HasanJamal96/bio_reactor/README.md

# bio_reactor

It is a device used to check total coliforms and E. coli in Liquids.
User place the jar in chamber and microcontroller check sample type and other information by reading its RFID tag.  
Sample Types
 - COLITAG
 - COLILERT
 - COLILERT18

after getting information device will perform specific tasks on sample and produce the results.
LEDs are used to display states.

Heating pad with PID is used to maintain certian temperature of liquid.  
After prducing result, result will be uploaded to the cloud with sample information.
