HasanJamal96/bio_reactor/Information.docx

Download and Install Arduino IDE 2.x from the following link.

https://docs.arduino.cc/software/ide-v2/tutorials/getting-started/ide-v2-downloading-and-installing

Add ESP32 board in IDE.

Go to File >> preferences.

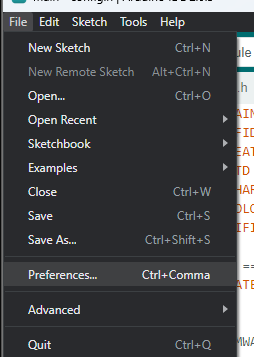
[picture p2: figure]

Add following link in Additional boards manager URLs.

https://raw.githubusercontent.com/espressif/arduino-esp32/gh-pages/package_esp32_dev_index.json

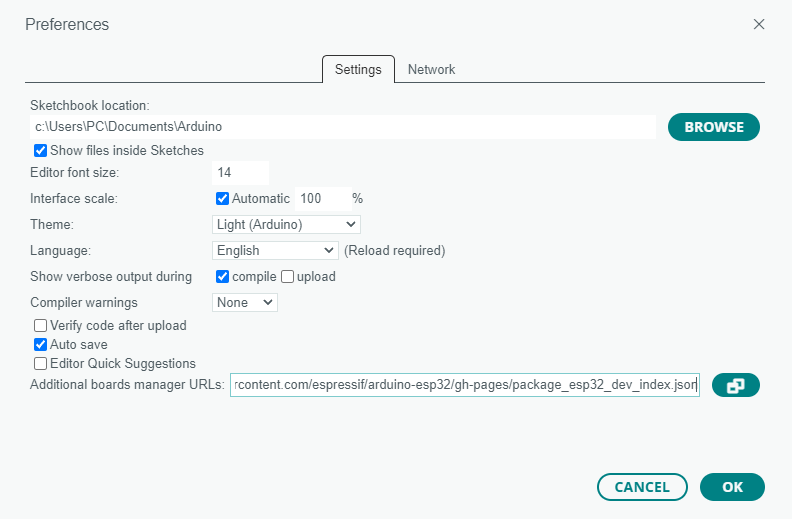
[picture p3: figure]

Click Ok.

Now go to Tools >> Boards >> Board Manager and search for ESP32 and install 1.0.6 version.

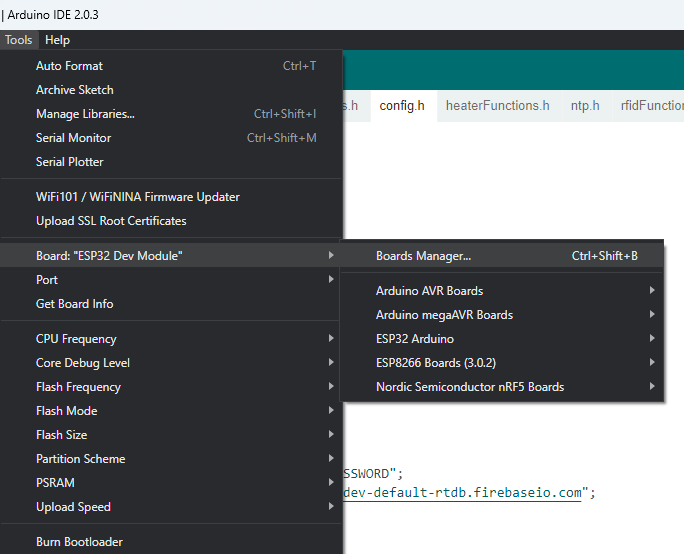
[picture p4: figure]
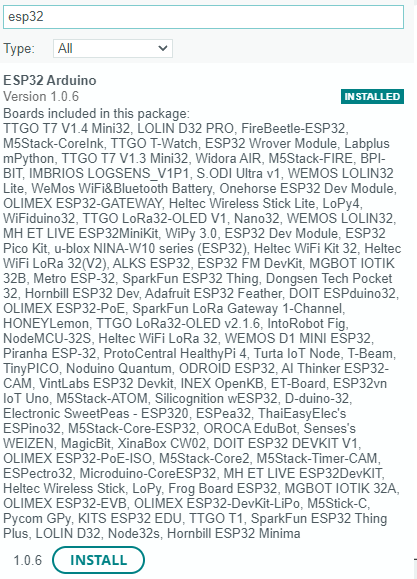
[picture p5: figure]

Adding Libraries

Open library manager.

Search for veml6040 and install. At time of this document 0.3.1 is the latest version.

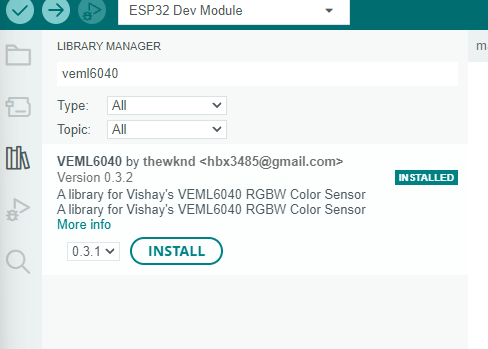
[picture p6: figure]

Search for TimeLib and install. At time of this document 1.6.0 is the latest version.

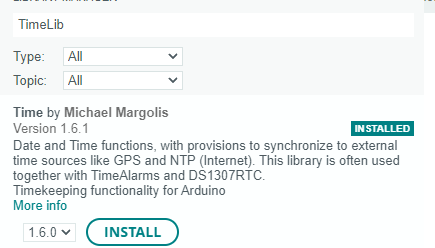
[picture p7: figure]

Search for NTPClient and install. At time of this document 3.2.1 is the latest version.

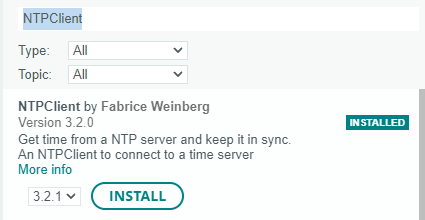
[picture p8: figure]

Search for MFRC522 and install. At time of this document 1.4.9 is the latest version.

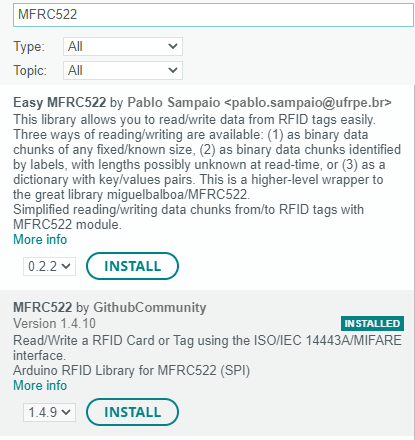
[picture p9: figure]

Search for Adafruit_MAX31865 and install. At time of this document 1.5.0 is the latest version.

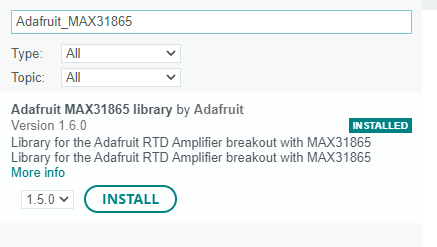
[picture p10: figure]

Update Config.h file.

Update Wi-Fi ssid and password.

Endpoints for different data.

Change RREF, RNOMINAL and TOLERANCE according to your need.

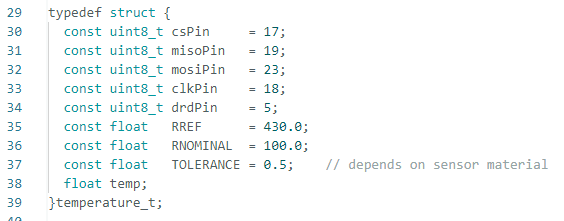
[picture p11: figure]

Change thermalPower of the material.

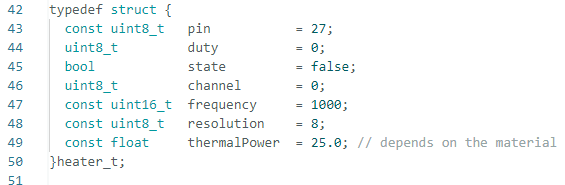
[picture p12: figure]

Update LUX value when code checks if Lid is open or not it will compare measured LUX with this LUX value and if measured LUX is greater than this LUX it will send error.

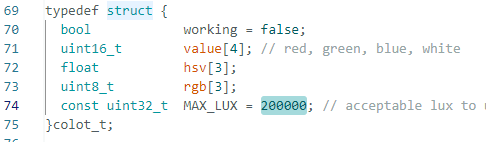
[picture p13: figure]

Adjust time in milli seconds. Intervals of White and UV Led.

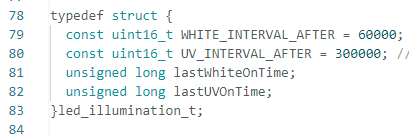
[picture p14: figure]

These are the different tests comparator color values.

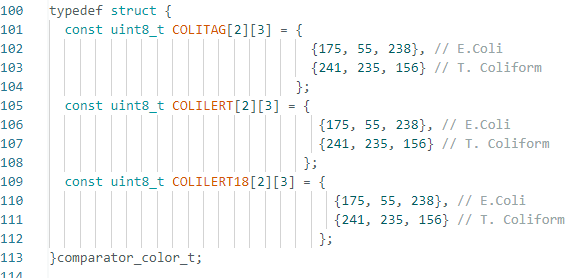
[picture p15: figure]

You can enable DEBUG messages by settings them true or disable them y setting their value fasle.

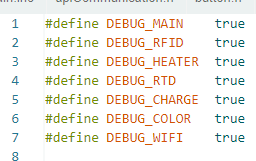
[picture p16: figure]

Baudrate is set 115200 for DEBUG messages.

If you disable DEBUG_MAIN no debug will show

Upload code

Connect ESP32 with PC.

Select COM port at which ESP is connected.

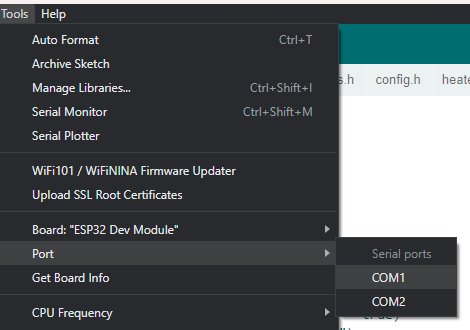
[picture p17: figure]

Select ESP32 board.

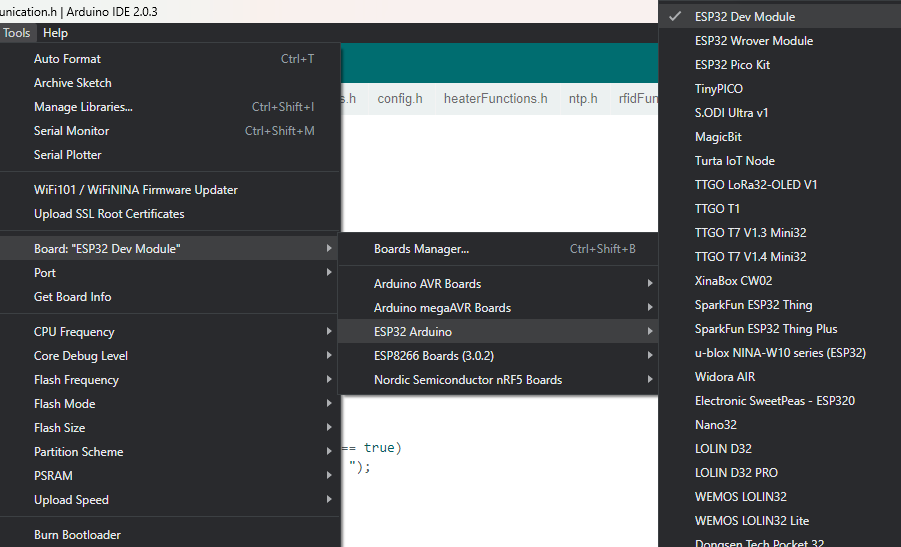
[picture p18: figure]
