HasanJamal96/bio_reactor/Documents/Screenshot 2023-02-04 132949.png

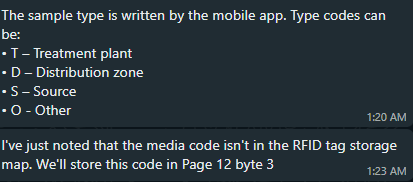
Documents/Screenshot 2023-02-04 132949.png
