HasanJamal96/bio_reactor/Documents/BioReactor.PDF

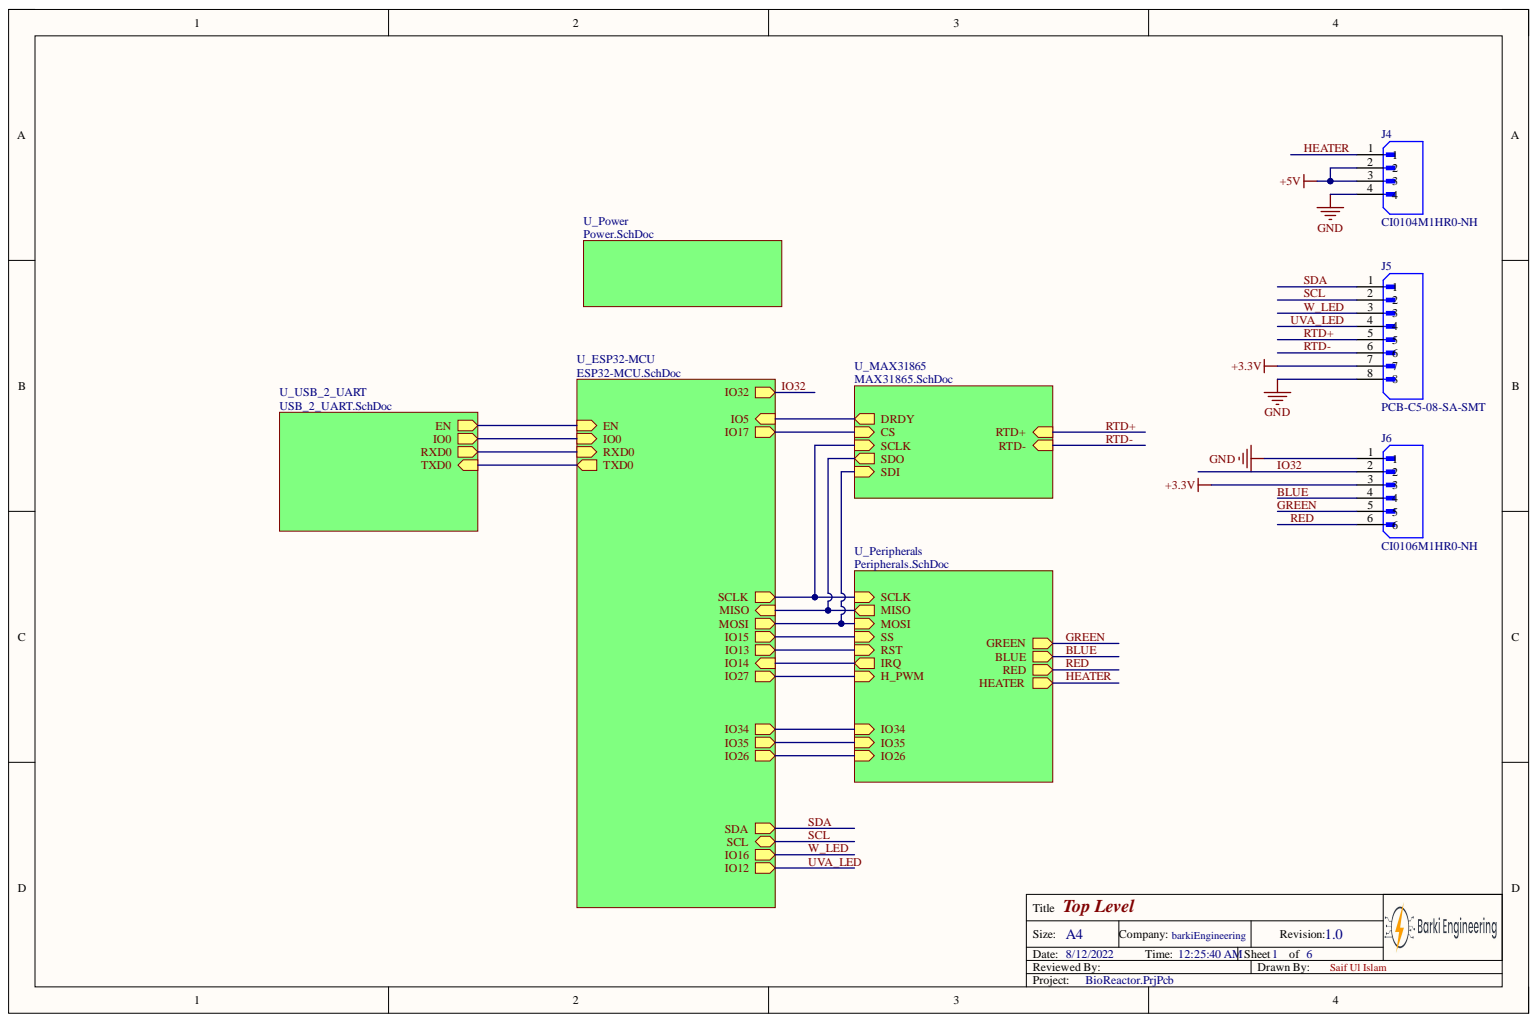
[picture p21: page 1]

Title Top Level

Size: A4 | Company: barkiEngineering | Revision: 1.0
Date: 8/12/2022 Time: 12:25:40 AM | Sheet 1 of 6

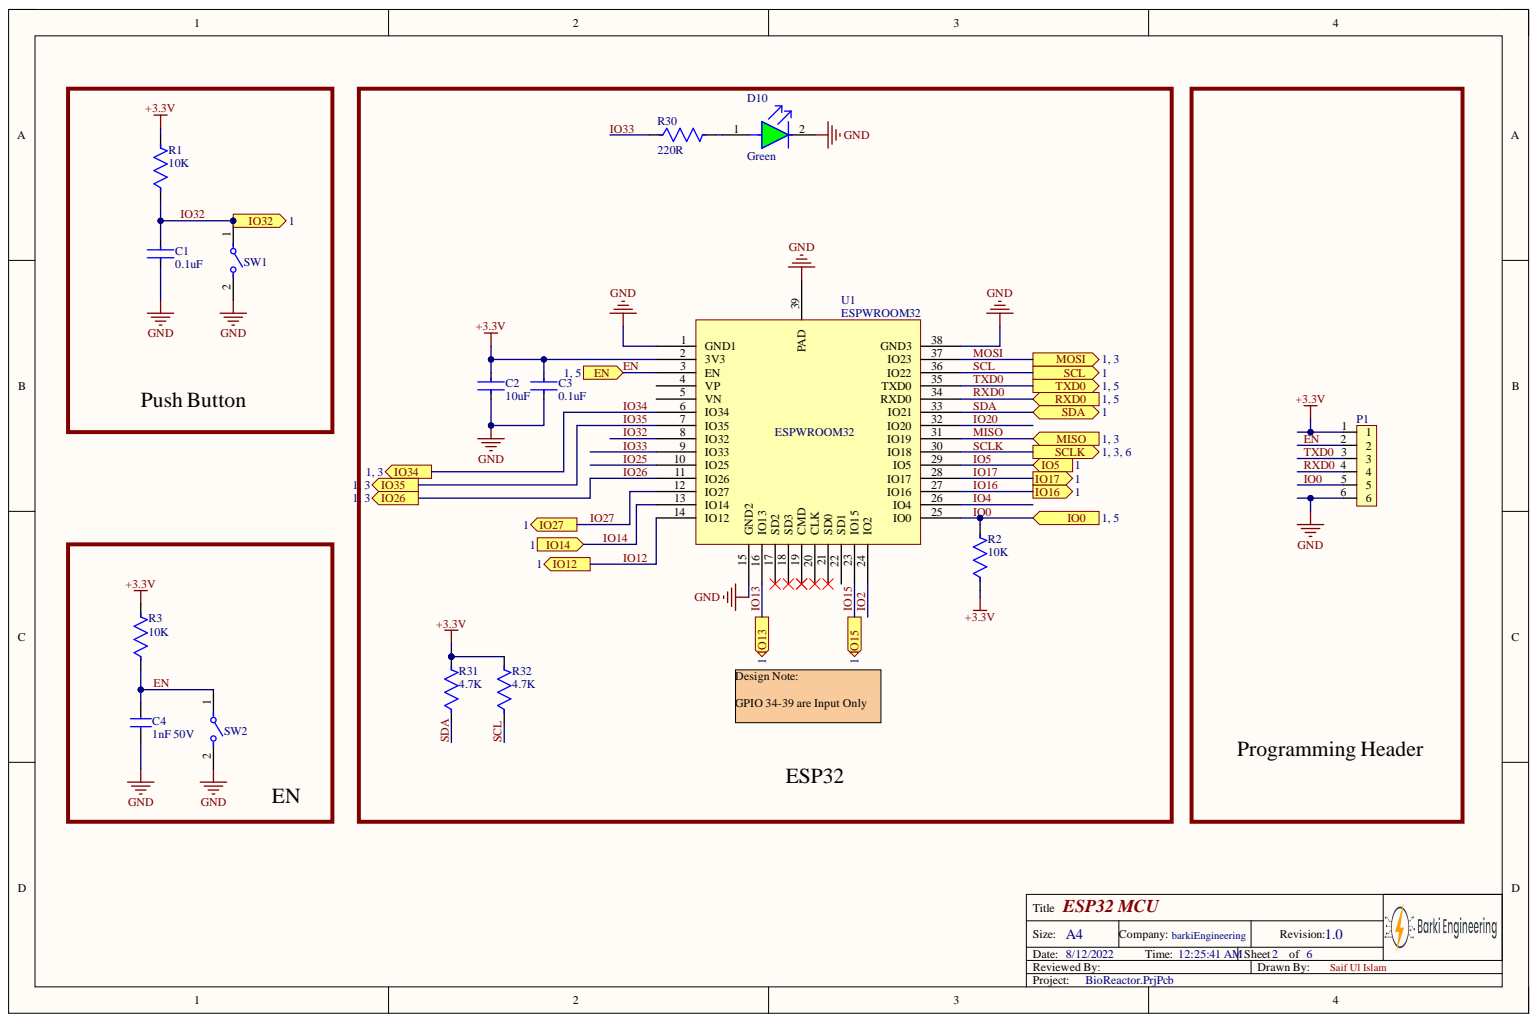
[picture p22: page 2]

1 2
1 3
1 4

T i tl e ESP3 2 MCU

Size : A 4 | Compan y : barki Engine ering | Rev i s i o n : 1 . 0
Dat e : 8 / 1 2 / 2 0 2 2 T ime : 1 2 : 2 5 : 4 1 A M | Shee t 2 o f 6

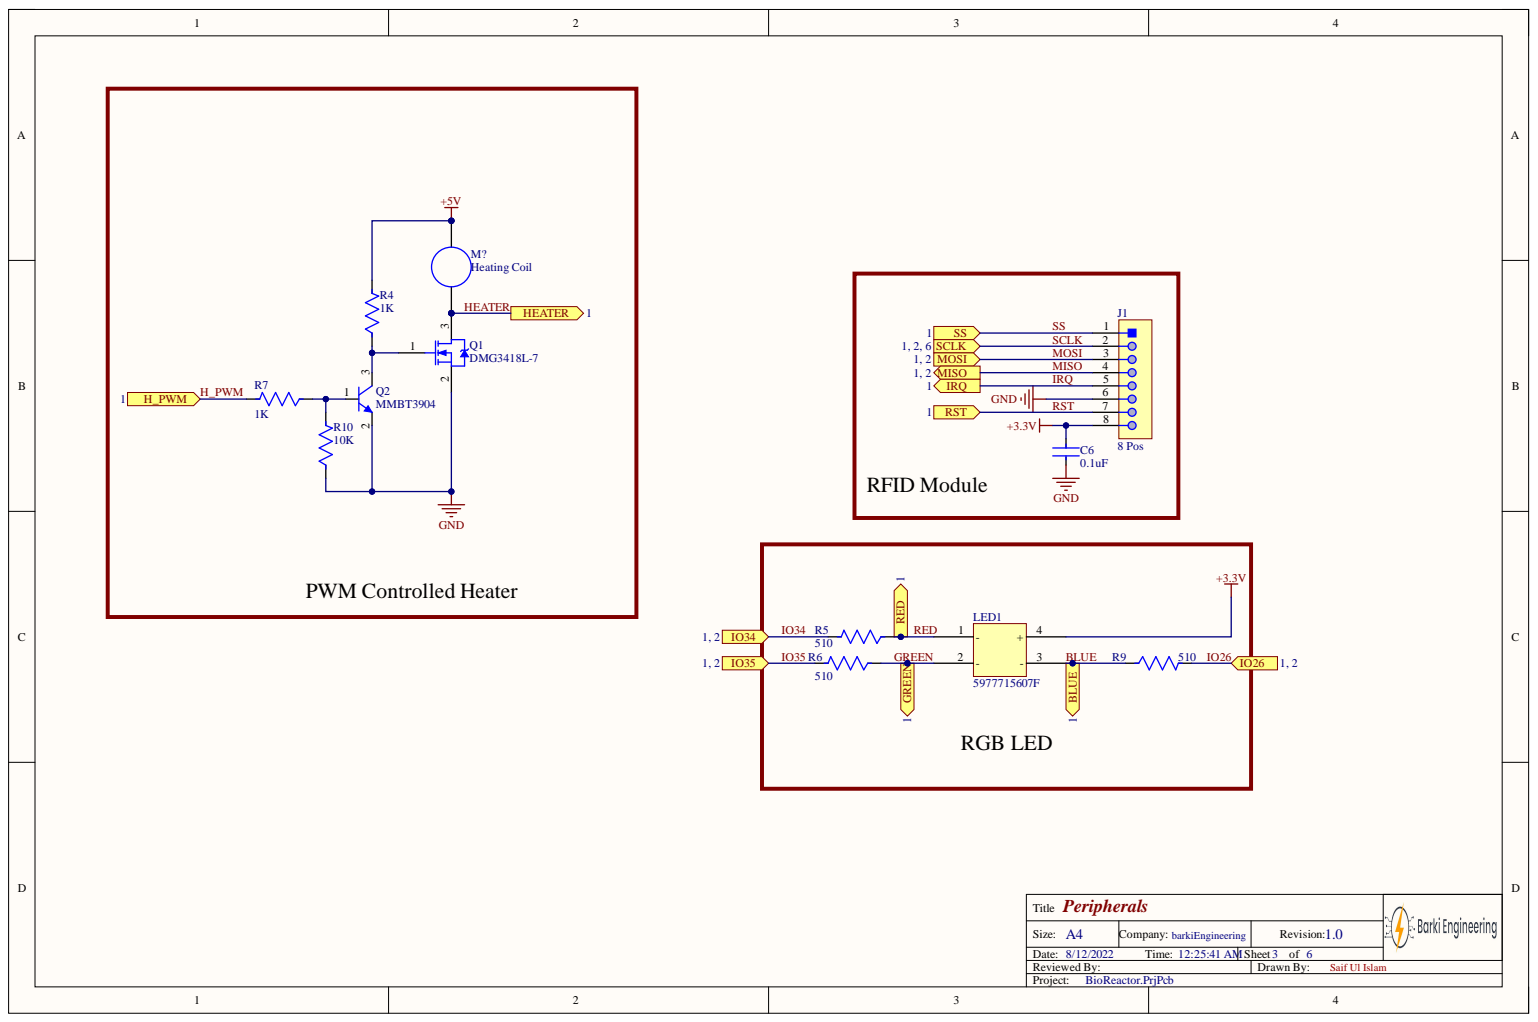
[picture p23: page 3]

Title Peripherals

Size: A4 | Company: barkiEngineering | Revision: 1.0
Date: 8/12/2022 Time: 12:25:41 AM | Sheet 3 of 6

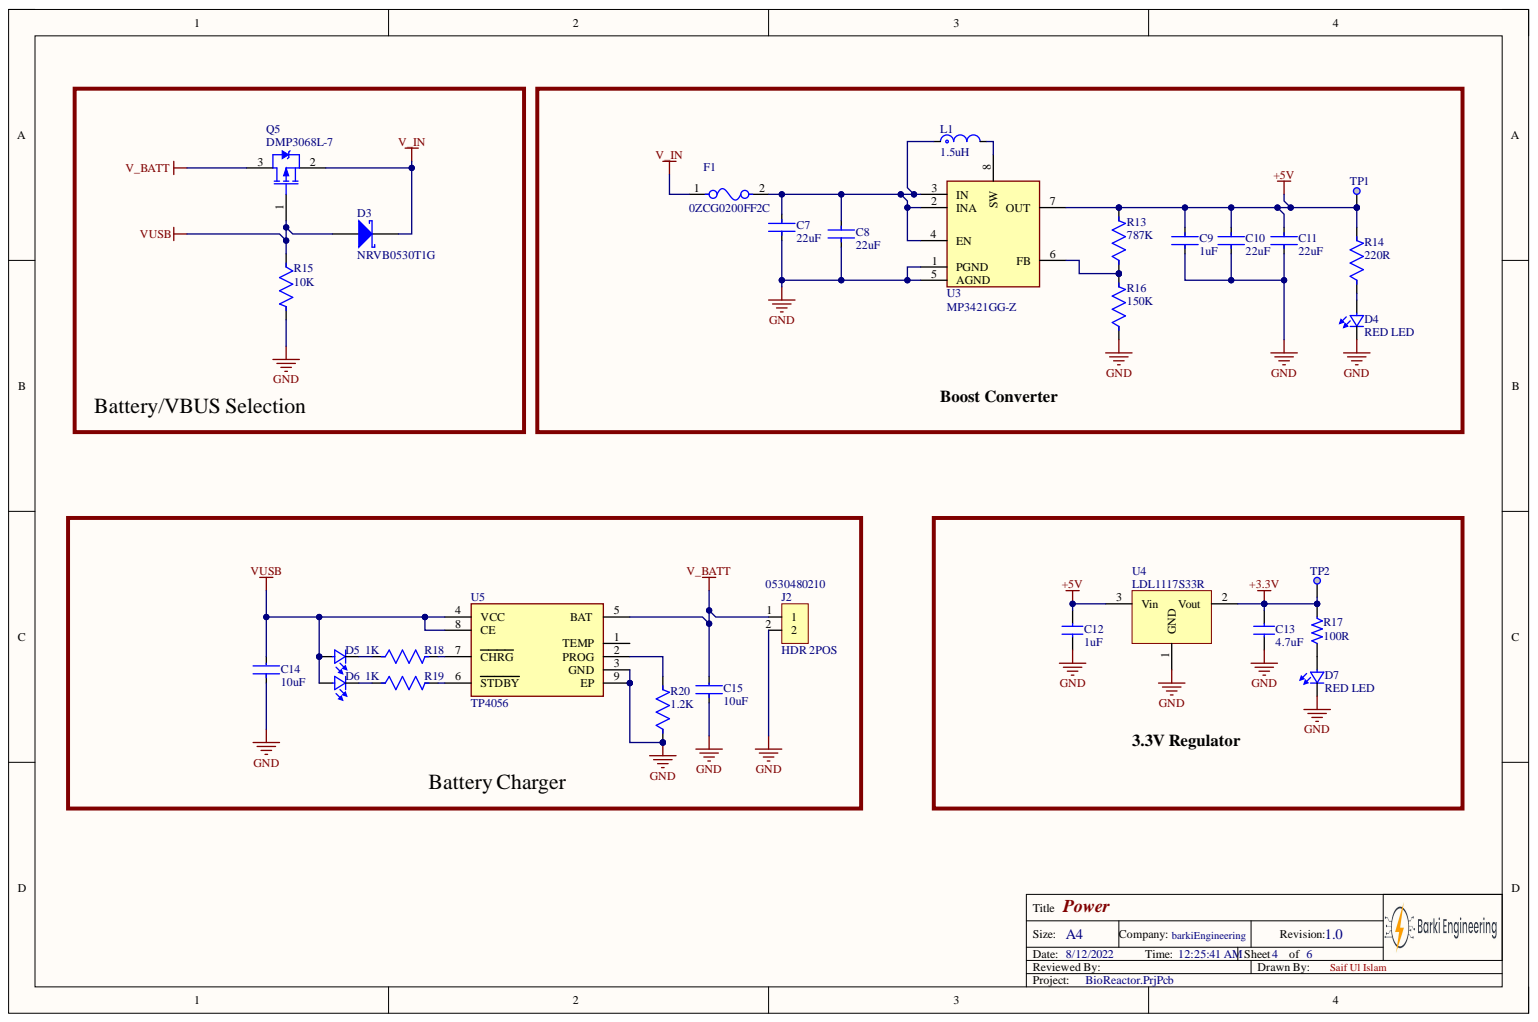
[picture p24: page 4]

EN 4 | GND

AGND 5

Boost Converter Battery/VBUS Selection

Title Power

Size: A4 | Company: barkiEngineering | Revision: 1.0
Date: 8/12/2022 Time: 12:25:41 AM | Sheet 4 of 6

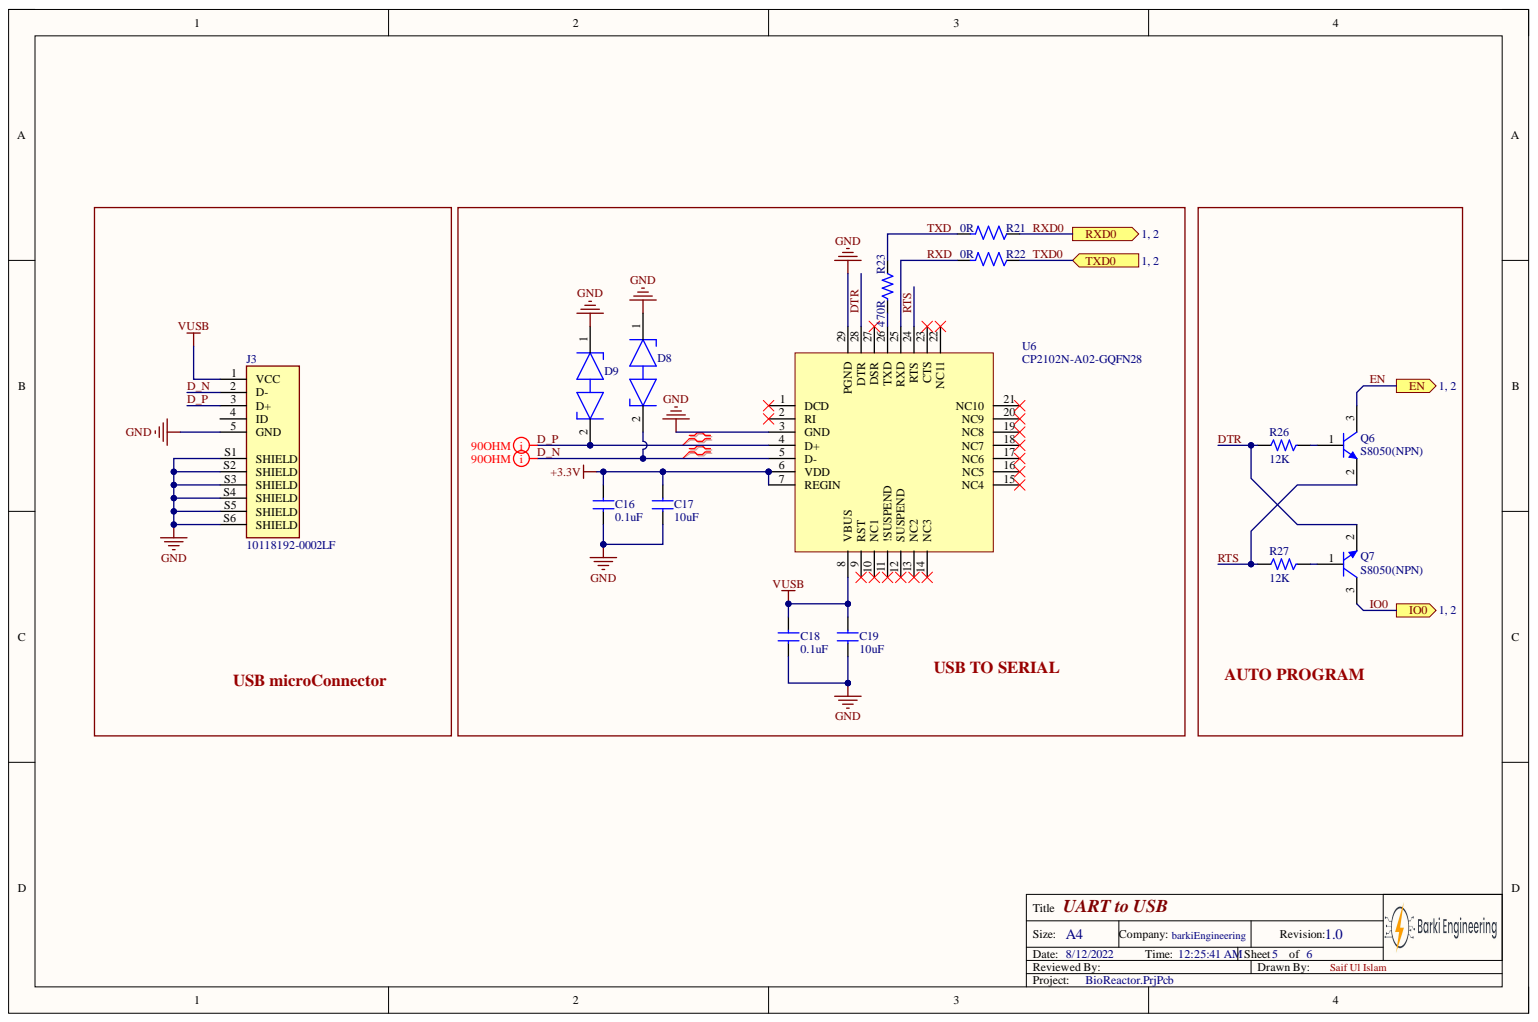
[picture p25: page 5]

NC11 22 CTS 23 RTS 24 RXD 25 TXD 26 DSR 27 DTR 28 PGND 29

T i tl e UART to USB

Size : A 4 | Compan y : barki Engine ering | Rev i s i o n : 1 . 0
Dat e : 8 / 1 2 / 2 0 2 2 T ime : 1 2 : 2 5 : 4 1 A M | Shee t 5 o f 6

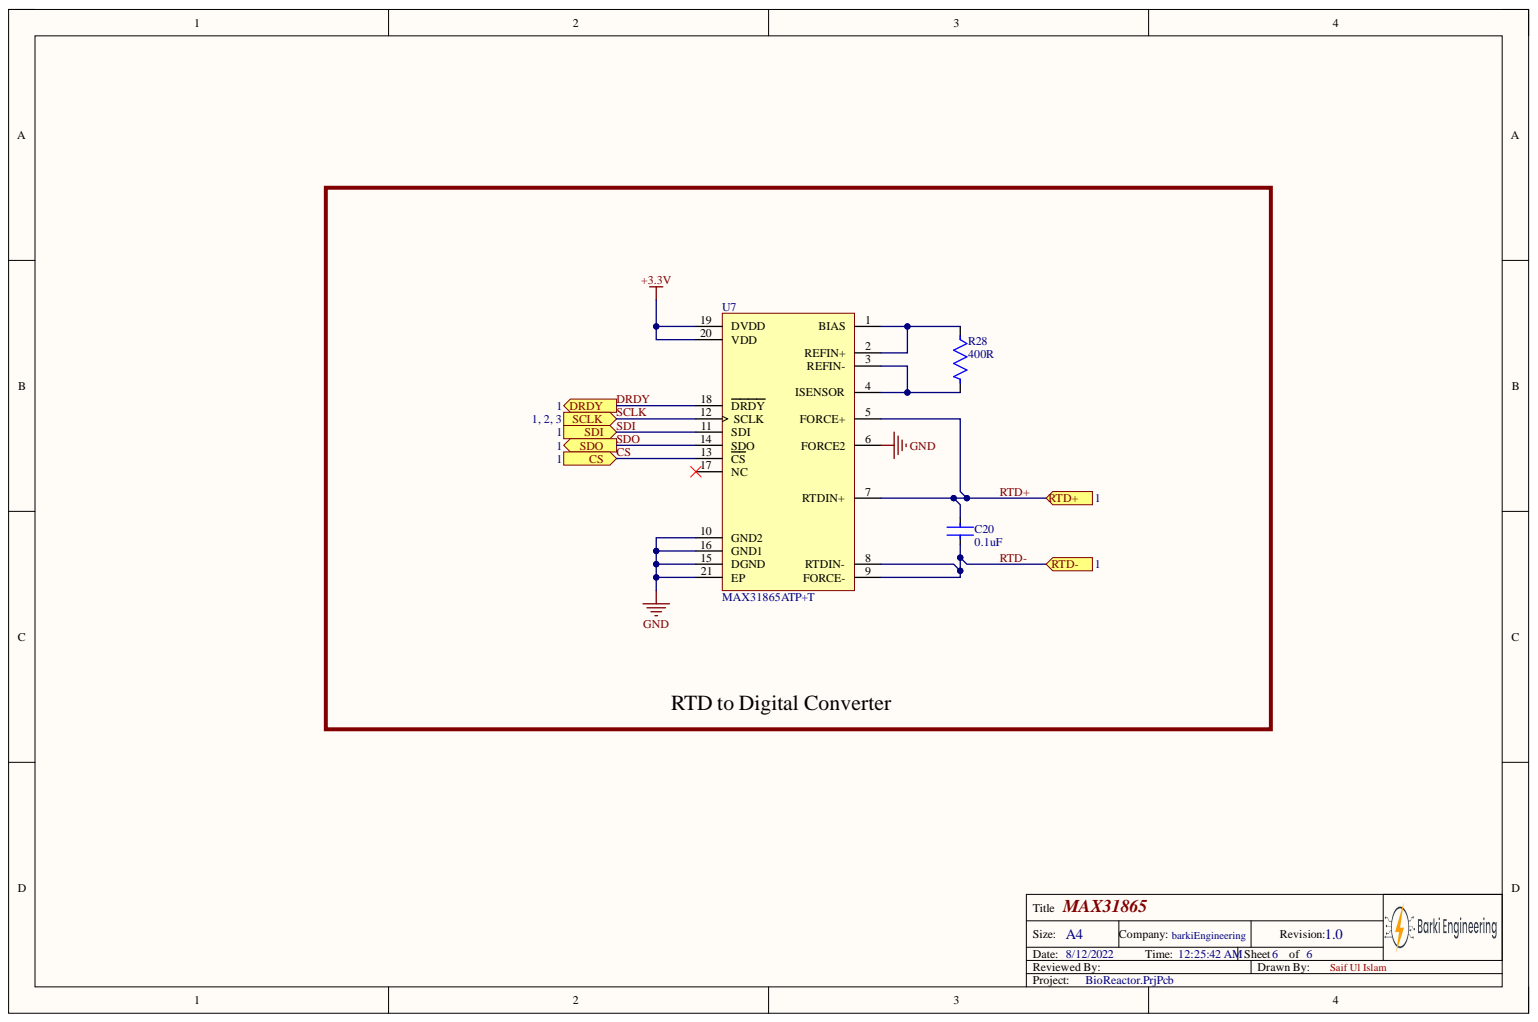
[picture p26: page 6]

RTD to Digital Co

T i tl e MAX3 1 8 65

Size : A 4 | Compan y : barki Engine ering | Rev i s i o n : 1 . 0
Dat e : 8 / 1 2 / 2 0 2 2 T ime : 1 2 : 2 5 : 4 2 A M | Shee t 6 o f 6
