HasanJamal96/bio_reactor/Documents/Heating_Board.PDF

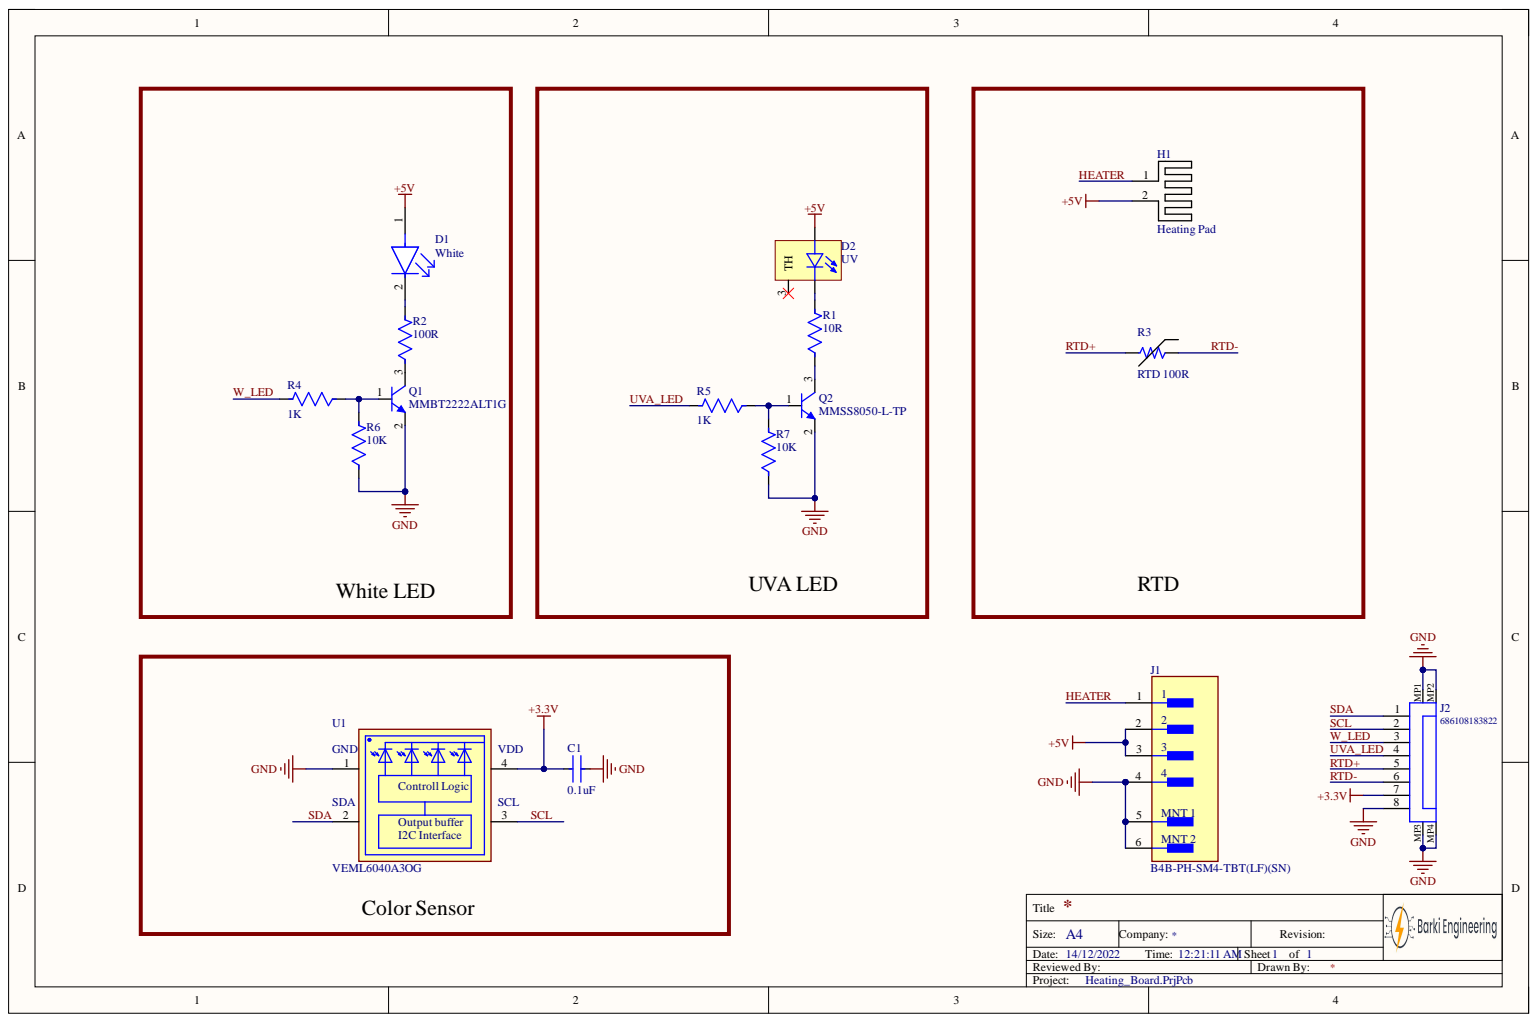
[picture p27: page 1]

B4B-PH-SM4-TBT(LF)(SN)

Title *

Size: A4 | Company: * | Revision:
Date: 14/12/2022 Time: 12:21:11 AM | Sheet 1 of 1
