HasanJamal96/bio_reactor/Documents/BioReactor (1).PDF

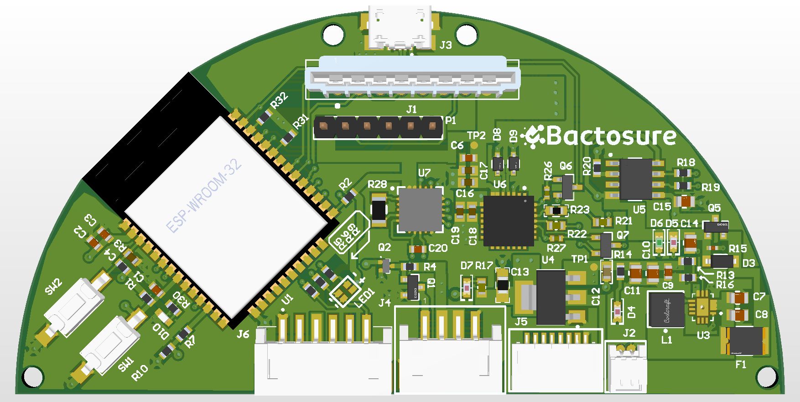
[picture p28: page 1]

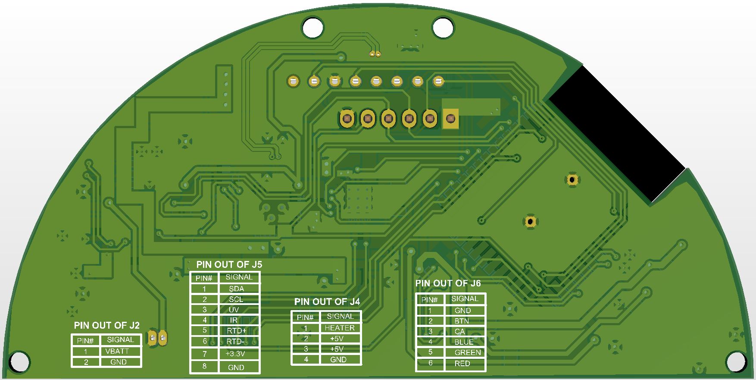
[picture p29: page 2]
