HasanJamal96/bio_reactor/Documents/Heating_Board (1).PDF

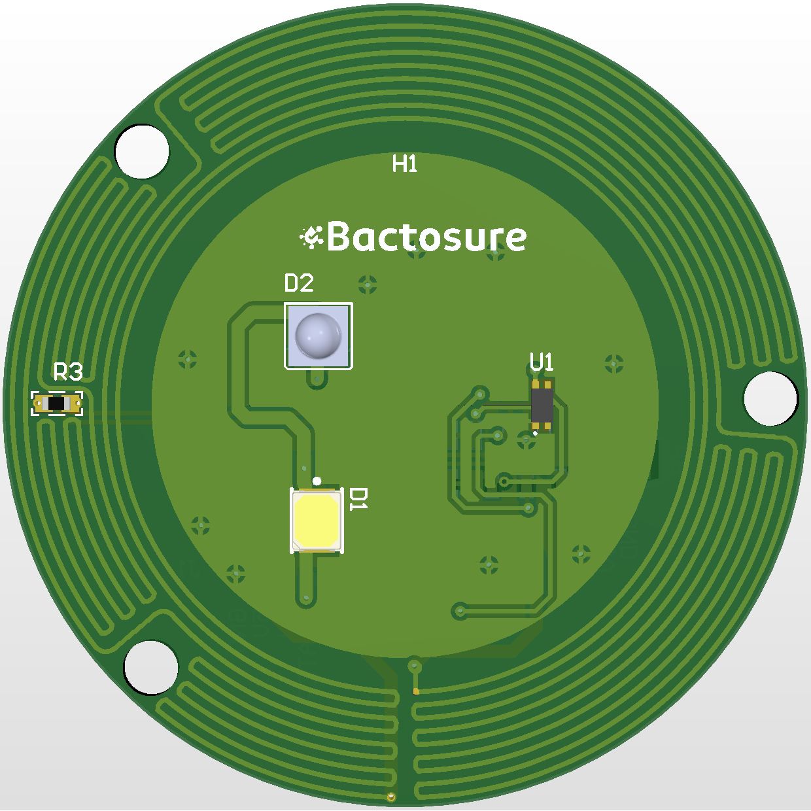
[picture p30: page 1]

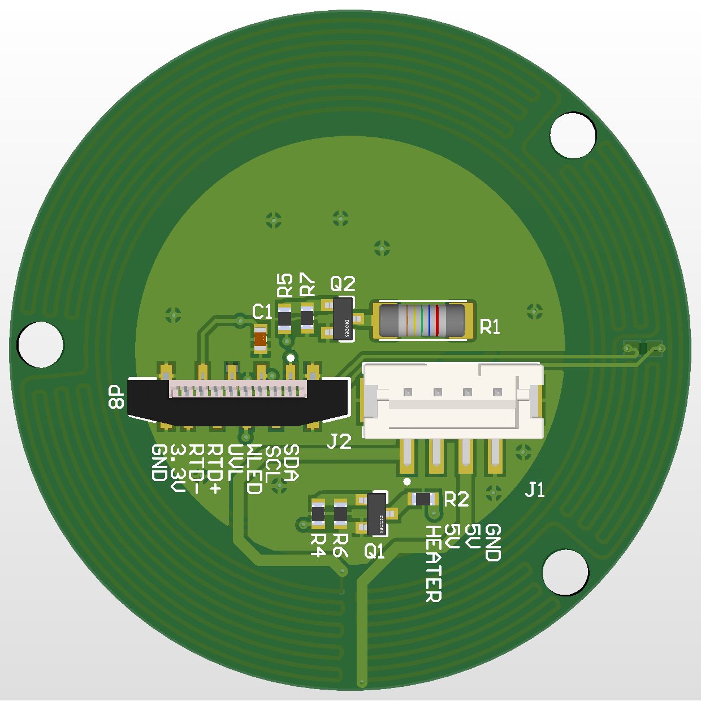
[picture p31: page 2]
